keenanhnelson/FidgetSpinner/3dModels/FidgetSpinner.stl

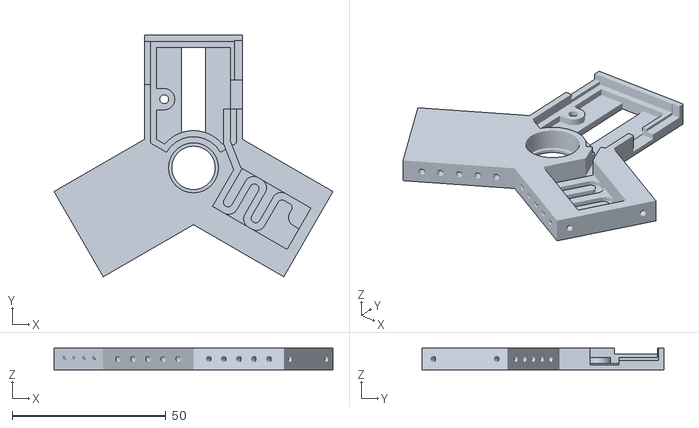
[picture p1: CAD file, 2023-10-29]
3dModels/FidgetSpinner.stl
90.7 x 78.5 x 7.00
