keenanhnelson/FidgetSpinner/3dModels/EndCapBottom.stl

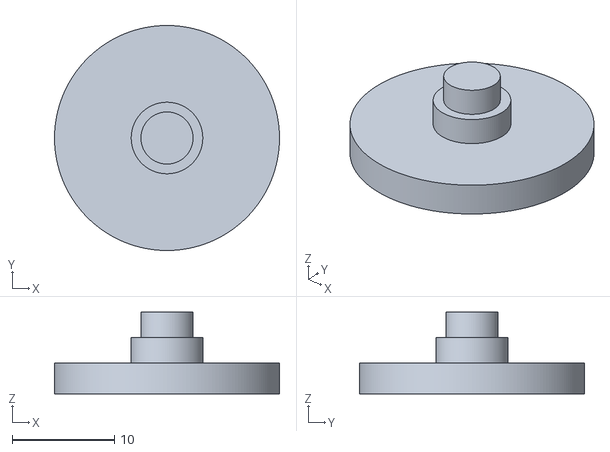
[picture p2: CAD file, 2023-10-29]
3dModels/EndCapBottom.stl
22.0 x 22.0 x 8.00
