keenanhnelson/FidgetSpinner/3dModels/EndCapTop.stl

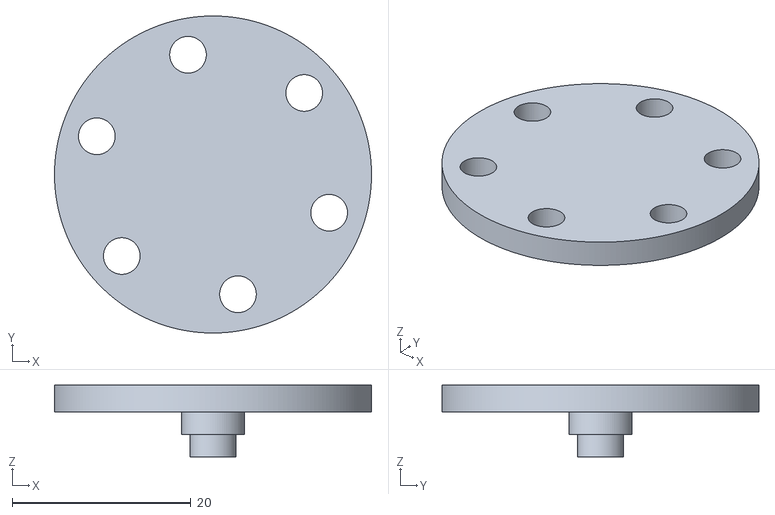
[picture p3: CAD file, 2023-10-29]
3dModels/EndCapTop.stl
35.5 x 35.5 x 8.00
