keenanhnelson/FidgetSpinner/Pcb/Schematic v29.pdf

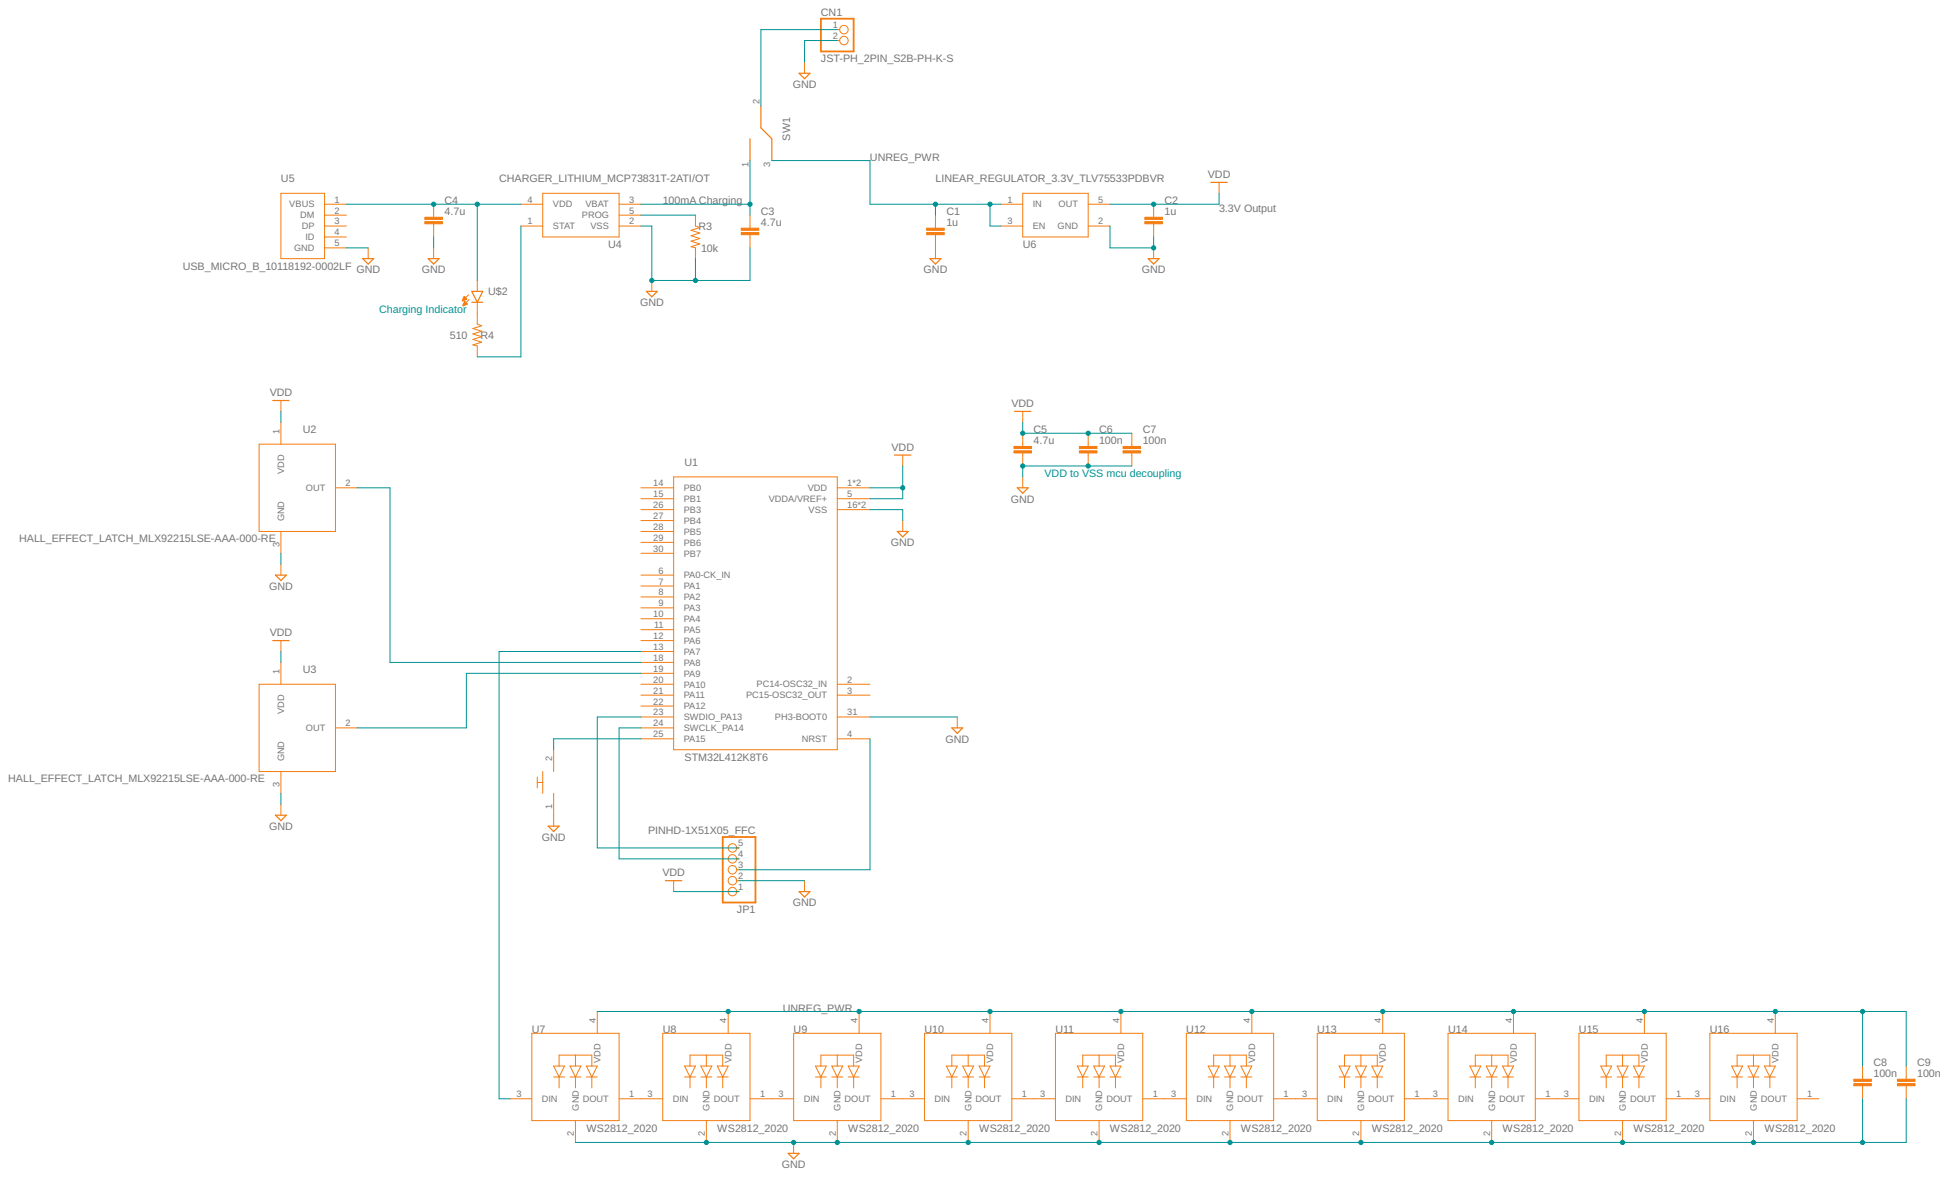
[picture p4: page 1]

VDD to VSS mcu decoupling
