keenanhnelson/FidgetSpinner/Code/Core/Src/main.c

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
/* Includes ------------------------------------------------------------------*/
#include "main.h"
#include "crc.h"
#include "dma.h"
#include "spi.h"
#include "tim.h"
#include "gpio.h"

/* USER CODE BEGIN Includes */
#include <string.h>
#include <stdlib.h>

#include "pixels.h"
#include "pixels_patterns.h"
#include "user_interface.h"
#include "kinematics.h"
/* USER CODE END Includes */


void SystemClock_Config(void);
/**
  * @brief  The application entry point.
  * @retval int
  */
int main(void)
{
  /* MCU Configuration--------------------------------------------------------*/

  /* Reset of all peripherals, Initializes the Flash interface and the Systick. */
  HAL_Init();

  /* Configure the system clock */
  SystemClock_Config();

  /* Initialize all configured peripherals */
  MX_GPIO_Init();
  MX_DMA_Init();
  MX_SPI1_Init();
  MX_TIM1_Init();
  MX_CRC_Init();
  MX_TIM2_Init();
  /* USER CODE BEGIN 2 */

  //Setup up speed monitoring
  initKinematics();

  //Setup and restore previous menu values
  MenuInfo menuInfo;
  bool saveMenuState = true;
  initMenu(&menuInfo, saveMenuState);

  //Setup pixels
  PixelsInfo pixelInfo;
  initPixels(&pixelInfo, WS2812B_2020, 10, 10000000);

  //Show a known pattern at start up for a little bit
  Rgb pixelsRgb[] = {
	{0x00, 0x00, 0x03}, {0x00, 0x00, 0x03}, {0x03, 0x00, 0x00}, {0x03, 0x00, 0x00}, {0x00, 0x03, 0x00},
	{0x00, 0x03, 0x00}, {0x03, 0x00, 0x03}, {0x03, 0x00, 0x03}, {0x03, 0x00, 0x03}, {0x03, 0x00, 0x03},
  };
  setPixelsRgb(&pixelInfo, pixelsRgb);
  HAL_Delay(500);

  /* USER CODE END 2 */

  /* Infinite loop */
  /* USER CODE BEGIN WHILE */
  while (1)
  {
	  ButtonPressType buttonPress = processButtonInput(&pixelInfo);
	  processMenu(&menuInfo, &pixelInfo, buttonPress);

	  //Display patterns for moving or stationary when not in menu
	  if(menuInfo.state == NotInMenu){
		  displayPixelPattern(&pixelInfo, pixelsRgb, &menuInfo);
	  }
    /* USER CODE END WHILE */

    /* USER CODE BEGIN 3 */
  }
  /* USER CODE END 3 */
}

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
