keenanhnelson/FidgetSpinner/Code/FidgetSpinner.ioc

Mcu.UserName=STM32L412K8Tx
PA1.Signal=SPI1_SCK
PA7.Signal=SPI1_MOSI
PA8.Signal=S_TIM1_CH1
PA9.Signal=S_TIM1_CH2
