keenanhnelson/FidgetSpinner/Code/Core/Inc/kinematics.h

#ifndef KINEMATAICS_H_
#define KINEMATAICS_H_

#include <stdint.h>

void initKinematics();
int16_t getEncoderCnt();
void resetEncoderCnt();
float getPosition();
float getRpm();

#endif /* KINEMATAICS_H_ */
