keenanhnelson/FidgetSpinner/(commit log)

2023-10-29 Added hardware
    [EndCapBottom.stl, EndCapTop.stl, FidgetSpinner.stl]
2023-11-09 Fixed rgbToPixel_ws2812b_2020 so MOSI is always low after sending data
    [main.c]
2023-11-14 Added ability to change pattern by holding down button
2023-11-14 Added driver code to version control
2023-11-19 Started menu user interface with interrupts
2023-11-19 Converted to pulling button state. Can select different patterns
2023-11-27 Updated driver code
2023-11-27 Fixed issue with light glitch
    Fixed by temporarily disabling interrupts
    [pixels.c]
2023-11-27 Moved rpm calculation outside interrupt
    This makes it so I don't have to disable interrupts before transmitting
    spi data because the interrupts don't take very long
2023-11-27 Changed spi to send data using dma
    This prevents issues with interrupts which caused the leds to glitch randomly
    [FidgetSpinner.ioc, main.c]
2023-11-27 Fix problem with menu values not hitting limits
    [pixels_patterns.c, pixels_patterns.h, user_interface.c, user_interface.h]
2023-12-04 Removed spi wrapper
2023-12-04 Refactored revolution_speed to kinematics
2023-12-04 Added ability to know if dma was still sending pixel data
